xBurak777/guelph-gym-live-counter/(commit log)

2026-08-04 chore: initial commit — repo scaffold, Next.js 14 app, Prisma schema, Neon Postgres, live-counter homepage
    - Next.js 14 App Router + TypeScript + Tailwind CSS
    - Prisma 6 ORM against Neon Postgres (cloud)
    - Real data models: Member, ScanEvent, GymSession, Facility
    - POST /api/scan: ESP32-facing endpoint w/ shared-secret auth
    - GET /api/occupancy: live counter data source
    - Homepage: hero + live counter (5s poll), capacity bar, crowd status face, avg visit time
    - Redesigned nav mirroring Guelph Fit & Rec IA (Fitness/Wellness, Skill Development, Membership, Sports & Clubs, Kids & Camps, About)
    - Real brand tokens (#C20430 red, #FFC72C gold) from harvested Fit & Rec site
    - Portfolio project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
2026-08-04 feat: add all 13 remaining program pages with real harvested content
    Fitness:
    - /fitness/personal-training — 8 trainers with real bios + assessment info
    - /fitness/group-classes — full landing complementing /nrg
    - /fitness/wellness — Pilates/Yoga, Group PT programs
    Skill Development:
    - /skills/aquatics — 2 pools spec, Aqua Fit, Lifesaving Society lessons
    - /skills/dance — real Fall 2026 instructors + class dates/fees
    - /skills/certifications — CPR/First Aid/NLS courses through 2027
    - /skills/martial-arts — BJJ, Karate, Muay Thai, Self-Defence, Tae Kwon Do
    Sports & Clubs:
    - /sports/drop-in — weekly rec calendar, activities × locations
    - /sports/intramurals — 14 sports, 3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
2026-08-04 Add search bar, Valued Members section, and fix LiveCounter band labels
    - New global site search: rich index of pages, programs, NRG classes, facilities,
    and all 16 staff members. Ranked scoring by title/keyword/description match,
    keyboard nav (arrows/enter/esc), category chips, mobile + desktop variants.
    - Real Valued Members and Staff content sourced from fitandrec.gryphons.ca:
    all 16 profiles with real photos and verbatim bio quotes. Homepage slider
    shows the 4 Featured team members; new /about/valued-members full roster page.
    - LiveCounter capacity bar: labels now anchor to their real threshold bands
    (Quiet 0-35, Moderate 35-65, Busy 65-85, Packed 85+) with tick markers so
    th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
2026-08-04 Polish search UI: wider dropdown on desktop, tuned placeholders
    - Desktop nav search dropdown now anchors right and is 380px wide (was 256px),
    so result titles no longer truncate.
    - Distinct 'nav' vs 'nav-mobile' variants: mobile dropdown fills width inside
    the opened menu; desktop dropdown floats out past the input.
    - Placeholders sized to the container: 'Search programs, staff…' on desktop,
    full 'Search programs, staff, hours…' on mobile.
2026-08-04 Fix nav horizontal overflow: tighten gaps/padding, shrink search box, hide site-name label until 2xl (>=1536px) so all 7 nav items + search + Join Now always fit within viewport
2026-08-04 Restore 'GRYPHON FIT & REC / UNIVERSITY OF GUELPH' label beside logo at xl+ (1280px+); tighten nav gap and search width so bigger logo + label + all 7 items + search + Join Now still fit without over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
2026-08-06 Add SolidWorks build guide for RFID gate demo enclosure (single-lane swing gate, 8 3D-printed parts, cavities dimensioned for ESP32/PN532/2.8in TFT/16x2 LCD/SG90)
2026-08-06 Fix Fusion API: remove read-only defaultLengthUnits setter, use createByReal for params
    [RFID_Gate_Builder.py]
2026-08-06 Fix: remove root component rename (Fusion disallows on unsaved docs)
    [RFID_Gate_Builder.py]
2026-08-06 Simplify script: fabrication-agnostic (wood or 3D print), remove split lines and printer-specific features
2026-08-06 Fix cut extrudes: explicitly pass target body so Fusion knows what to cut into
    [RFID_Gate_Builder.py]
2026-08-06 Redesign v3: tall rectangular pillars matching LIDE reference, single door with 2 servos, TFT housing on top, LED grooves, LCD slots
    [RFID_Gate_Builder.py]
2026-08-06 Add ESP32 gate controller firmware
    - gate_controller.ino: state machine (IDLE/SCANNING/SUCCESS/DENIED/ERROR)
    - PN532 I2C RFID reader integration
    - ILI9341 2.8" TFT + 16x2 I2C LCD status displays
    - Dual SG90 servo door control (auto-close after 3s)
    - WiFiManager captive portal for zero-config WiFi
    - HTTPS POST to /api/scan with Bearer auth
    - Complete wiring guide, setup guide, and bench-test procedure
    [config.h, gate_controller.ino]
2026-08-06 Add ESP32 firmware bench-test sketches (blink, I2C scanner, PN532 reader)
    Incremental test sketches used to bring up the RFID gate hardware:
    - 01_blink: verifies toolchain (driver, board files, USB data cable, upload)
    - 02_i2c_scanner: probes I2C bus, confirms PN532 responds at 0x24
    - 03_pn532_reader: reads Mifare Classic S50 card UIDs
    Bench test log:
    PN532 firmware: 1.6
    Test card 1 UID: 47:07:12:5E
    Test card 2 UID: 26:8C:75:E7
    Each sketch has header comments documenting purpose, wiring, expected output,
    and pass criteria. Tests must be run in order — each proves a prerequisite
    for the next.
    Next: 04_tft_hello (2.8" SPI TFT graphics hello world).
2026-08-06 Add TFT demo v2 sketch — polished 3-state UI preview
    Sketch 04 proves the ILI9341 SPI display works and demonstrates the
    target UI language for the gate demo:
    STANDBY → 'TAP CARD' with Gryphon-red header + gold occupancy bar
    SUCCESS → Green checkmark, welcome message, member ID
    DENIED → Red X-mark, 'ACCESS DENIED' with staff instruction
    Screens cycle every 4 seconds and auto-redraw on each state change,
    which self-heals if the display encounters a transient reset.
    Bench test result: all 3 states rendered correctly at 240x320 portrait.
    Backlight stable when LED pin is on 3V3 (not 5V).
    Uses hardware SPI (MOSI=23, SCK=18, MISO=19) with three unique
    control pins (CS=5, RESE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
    [04_tft_demo.ino]
2026-08-09 Phase B.3: dual servo sweep sketch (D15 + TX2/GPIO17)
    - Servo LEFT on D15 confirmed working
    - Servo RIGHT moved from RX2 to TX2 (GPIO 17) after diagnosis
    - Fast sweep: 4ms/step = ~360ms per 90 degree sweep
    - Second physical servo confirmed dead by swap test
    - Awaiting replacement SG90 pack for final integration
    [05_dual_servo.ino]
2026-08-09 Master build guide: complete RFID gate system
    - 00_MASTER_BUILD_GUIDE.md: end-to-end assembly instructions
    - 01_ir_discover.ino: IR remote code capture sketch
    - gate_controller.ino: full integrated firmware (868 lines)
    - WiFi captive portal (WiFiManager)
    - State machine (BOOT/STANDBY/ACTIVE/SCANNING/APPROVED/DENIED)
    - PN532 RFID via I2C
    - TFT ILI9341 UI with 5 screens
    - LCD1602A secondary display via I2C
    - PCA9685 4-servo control (2 per door, synchronized)
    - KY-022 IR remote (ELEGOO)
    - Push button (short press = toggle, long press = WiFi reset)
    - HTTPS POST to /api/scan with Bearer token
    - /api/occupancy polling
    - WIRING_QUICK_REFERENCE.md: printable pin-by-pin cheat shee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
    [01_ir_discover.ino, gate_controller.ino]
2026-08-17 Integrate ESP32 live occupancy backend
